Carlot0327/Wireless-signal-transmission-Signal-processor/5.document/20251323-航空语音通信质量监测与报警系统-胡伟畅-刘丹、黄建宇/20251323-航空语音通信质量监测与报警系统-胡伟畅-刘丹、黄建宇-项目海报/微信图片_20260104143353_129_1.jpg

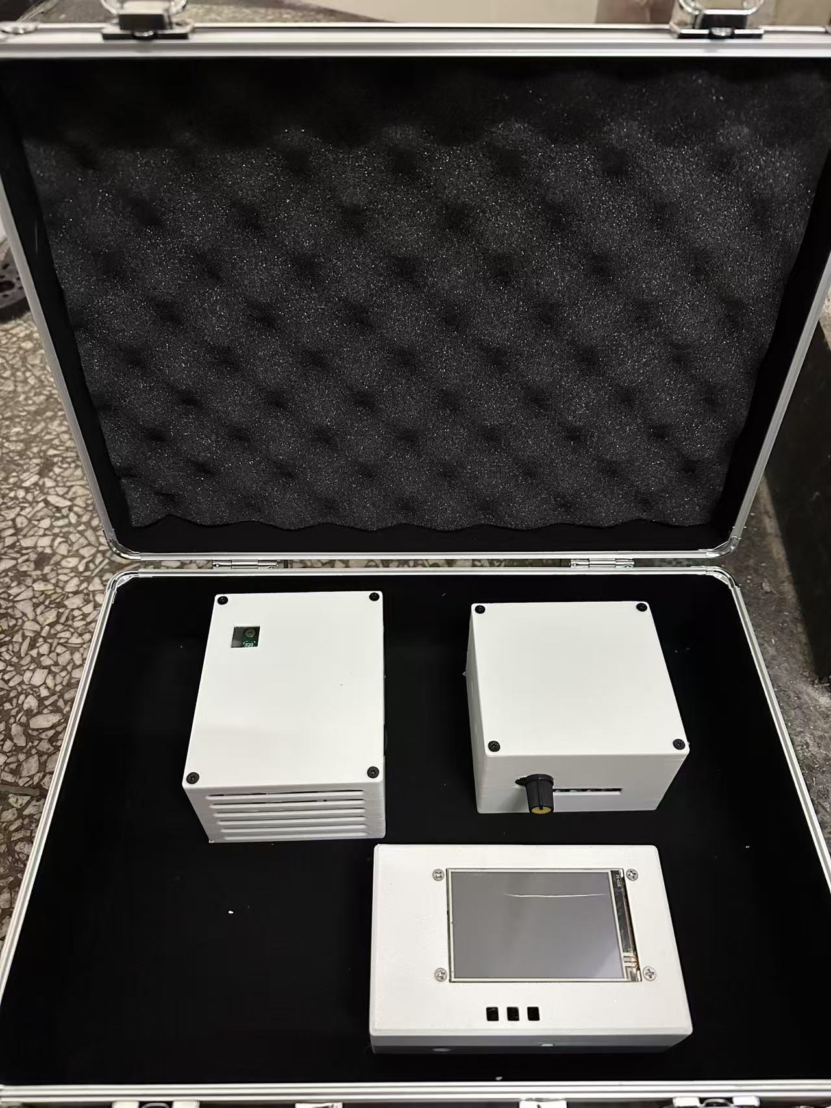
5.document/20251323-航空语音通信质量监测与报警系统-胡伟畅-刘丹、黄建宇/20251323-航空语音通信质量监测与报警系统-胡伟畅-刘丹、黄建宇-项目海报/微信图片_20260104143353_129_1.jpg
