Carlot0327/Wireless-signal-transmission-Signal-processor/5.document/航空语音通信质量与报警系统项目商业计划书.docx

商业计划书

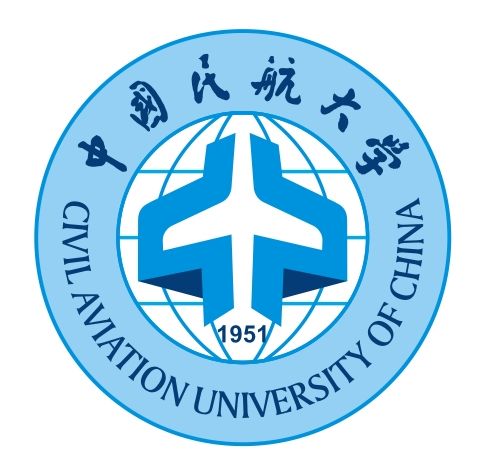
[picture p120: figure]

航空语音通信质量检测与报警系统

团队编号： | 2025-13-23
学生姓名： | 胡伟畅、郝成城、丰国庆、刘相炜、李竺韵
专 业： | 电子信息工程（CDIO试点班）、工商管理
| （卓越试点班）
指导教师： | 刘丹、黄建宇、张明凤
学 院： | 电子信息与自动化学院、经济与管理学院

二〇二五年十二月

目录

## 摘要

本项目精准聚焦现代航空语音通信领域的核心安全痛点，研发集多重功能于一体的航空语音通信质量监测与报警系统，构建全流程闭环管控体系，填补中小型航空企业及科研机构的技术空白。核心核心信息如下：

核心定位：破解地空传输链路信号受电磁干扰、环境噪声、设备老化等因素影响导致的通信质量下降难题，保障航空航行安全。

核心技术路线：采用低功率中波模拟通信技术，融合STM32嵌入式实时处理与MATLAB高精度信号分析双路径方案，符合国家无电台执照设备功率管控要求。

核心性能指标：

- 检测带宽：150~4.5kHz
- 频带分辨率：35Hz
- 检测分辨率：0.01dB
- 失真度分辨率：0.01%
- 报警响应时间：<1s

核心功能覆盖：信号实时采集、关键指标分析、异常快速报警、数据存储与可视化展示。

项目核心竞争优势源于模块化架构设计与全链条成本控制，形成四大核心壁垒，支撑市场竞争力与商业化推广：

兼容性优势：模块化设计+标准化接口，可灵活对接不同型号航空通信设备，覆盖通用航空运维、机场安全巡检、设备研发测试、科研教学实验等多元场景。

成本优势：硬件总成本严格控制在1354.78元以内，远低于行业同类设备3000元以上的成本水平，性价比突出，易切入中低端市场。

技术稳定性优势：硬件采用磁珠隔离、去耦电容等抗干扰设计，双路径数据处理方案协同优化，可在复杂环境下稳定运行，满足航空通信实时性、可靠性要求。

合规性优势：发射功率≤10W，符合国家无线电管理规定，无需额外申请电台执照，降低客户准入门槛与运营成本。

# 第1章 项目概述

## 1.1 项目背景

地空语音通信是航空运输体系的核心纽带，其质量稳定性直接关系飞行安全。

### 1.1.1 通信链路核心隐患

自然环境干扰：大气噪声、雷电天气等导致信号衰减、失真；

人为电磁干扰：机场周边工业设备、民用通信设备等产生的辐射信号破坏通信完整性；

设备自身故障：航空器通信设备老化、地面接收装置故障等引发通信中断或质量下降。

### 1.1.2 行业安全需求迫切

据民航局发布的《通用航空安全发展报告》统计，近年来我国通用航空领域因通信质量问题引发的安全事件占比达15%以上，其中60%以上的事件与通信信号干扰、设备故障未及时发现相关，凸显了通信质量实时监测的必要性与紧迫性。

### 1.1.3 政策合规要求严格

我国明确规定无电台执照设备发射功率不得超过10W，传统航空通信模拟系统难以满足合规要求。当前市场主流航空通信监测设备参数对比情况如下表所示：

表 1 当前市场主流航空通信监测设备参数对比情况

参数维度 | 本项目产品 | 传统高端设备 | 传统中端设备
发射功率 | ≤10W（合规） | 20-50W（需电台执照） | 15-25W（需电台执照）
市场售价（元） | 2800-4500 | 8000-15000 | 3000-8000
操作难度 | 简单（触摸操作，即插即用） | 复杂（需专业调试） | 中等（需电脑辅助）
信噪比测量精度 | ±2dB | ±1dB | ±3dB
失真度测量精度 | ±1% | ±0.5% | ±2%

由上表可知，本项目产品在保障核心测量精度基本满足需求的前提下，具备明显的合规性与成本优势，同时操作难度更低，更适配中低端市场需求。

### 1.1.4 市场供给缺口显著

从市场需求结构来看，当前航空通信监测市场呈现“两极分化”特征：

高端市场被少数国际品牌垄断，功率偏大、结构复杂、调试难度高、成本高昂（3000-8000元）、操作繁琐，主要服务于大型航空公司与枢纽机场；

中低端市场则存在明显供给缺口，中小型航空企业、地方机场、航空院校等主体的低成本、轻量化监测需求，航空院校的易用性、经济性教学科研需求均存在供给空白。

在此行业背景下，市场亟需一款兼具低成本、高可靠性、符合合规要求、操作便捷的航空语音通信质量监测解决方案，以填补中小型航空企业及科研机构的市场空白，完善航空通信安全保障体系的细分领域覆盖，推动航空通信监测行业的普惠化、规范化发展。本项目正是基于这一市场痛点，精准定位中低端市场，通过技术创新与成本优化，打造符合市场需求的高性价比产品，具备广阔的市场发展空间。

## 1.2 产品介绍

### 1.2.1 核心功能

系统核心功能围绕“实时监测、精准分析、快速预警、数据留存”四大核心目标构建，形成全流程闭环管控体系，各功能模块协同工作，确保通信质量的全方位掌控。

信号采集与实时监测环节，系统通过高精度音频采集模块对航空语音通信信号进行持续采集，采样率≥20kHz，可完整捕捉语音信号的细节特征，同时同步采集通信链路的电压、电流等辅助参数，为后续分析提供全面数据支撑。采集到的信号经预处理后，传输至STM32核心处理单元，实时分析信噪比、失真度等关键质量指标，分析结果通过触摸串口屏实时展示，工作人员可直观掌握通信质量动态变化，实现对通信链路的全天候实时监控。

异常报警功能是保障飞行安全的关键环节，系统预设信噪比、失真度等指标的安全阈值，当检测到通信链路故障、信号干扰或指标超标等异常情况时，可快速触发声光报警机制：蜂鸣器发出高频报警声，音量≥80dB，确保在嘈杂的机场环境中工作人员能够及时察觉；RGB LED灯发出红色闪烁灯光，通过视觉警示强化报警效果，整个报警响应时间≤1s，为故障处置争取宝贵时间。同时，系统支持报警阈值自定义设置，客户可根据自身使用场景与通信设备特性，灵活调整阈值参数，提升报警功能的适配性。

数据处理层面，系统创新采用“本地实时处理+云端精准分析”的双模式架构，兼顾时效性与精度需求。本地处理模式依托STM32芯片的强大运算能力，实现指标计算与数据格式转换，满足现场快速分析与决策需求；云端精准分析模式则通过TRS接口将采集到的原始信号传输至MATLAB系统，利用MATLAB的专业信号处理算法开展高精度降噪处理与离线深度分析，可精准提取信号特征参数，生成详细的数据分析报告，为设备性能优化、通信链路升级等提供深度数据支撑。此外，双模式架构支持数据互通与协同优化，本地处理的关键数据可同步至MATLAB系统进行二次校验，MATLAB的分析模型参数也可反向同步至本地系统，提升实时处理精度。

数据存储与可视化展示功能为后续运维与分析提供坚实保障。系统配备大容量本地存储模块，可连续存储不少于30天的监测数据（含原始信号、指标分析结果、报警记录等），支持按时间、设备编号、故障类型等多维度检索，方便工作人员追溯历史数据、排查故障根源。可视化展示通过分辨率≥800×480像素的触摸串口屏实现，采用直观的图表化呈现方式：实时显示信噪比、失真度等核心指标的动态变化曲线，用不同颜色标注指标正常、预警、超标三种状态；同步展示通信信号的频谱图，清晰呈现信号频率分布与干扰情况。同时，触摸操作支持参数设置、数据导出、报警记录查询等功能，工作人员可通过屏幕直接完成操作，无需额外连接电脑，大幅提升现场使用便捷性。

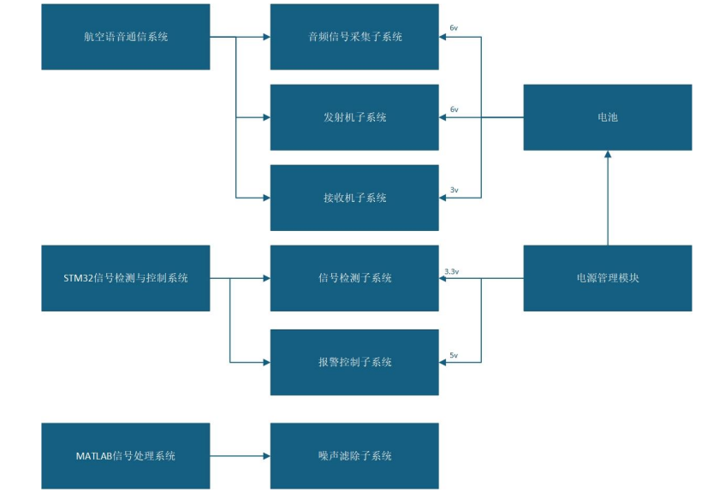
[picture p121: figure]

### 图 1 总系统图

### 1.2.2 技术参数

系统核心技术参数经严格测试校准，全面覆盖质量测量、通信性能、信号处理、环境适应四大维度，确保满足实际应用需求：

核心质量指标测量参数：检测带宽：150~4.5kHz；频带分辨率：35Hz；检测分辨率：信噪比0.01dB；失真度：0.01%；报警响应时间：<1s。

通信性能参数：工作频率范围为1000kHz~2000kHz；发射功率≤10W，符合国家无线电设备功率规定，无需额外申请电台执照。

信号处理参数：信号采样率≥20kHz；分析能力支持256点浮点FFT运算，具备良好的信号分析与频谱解析能力。

环境适应性参数：工作温度范围为-10℃~50℃；相对湿度范围为30%~80%；平均无故障工作时间≥1h，可适配机场露天运维、室内科研实验等多场景。

### 1.2.3 系统架构

系统采用模块化分层架构设计，主要由四大核心模块组成，各模块协同工作实现全功能落地。

航空语音模拟通信系统作为信号源核心，包含音频采集、发射机、接收机三大子模块，依次完成语音信号的采集捕捉、调制发射与解调还原，为后续监测分析提供稳定的信号输入；

STM32信号检测与控制系统是整个系统的核心处理单元，承担信号采集、关键指标计算、异常报警触发以及人机交互控制等核心任务，保障系统的实时响应能力；

MATLAB信号处理系统作为高精度分析补充，通过TRS接口接收STM32传输的信号数据，开展高精度降噪处理与离线深度分析，提升数据处理的灵活性与精度；

辅助模块则包含电源管理与人机交互两大子模块，其中电源管理模块可稳定提供3V、3.3V、5V多种电压输出，满足不同元器件的供电需求，人机交互模块通过触摸串口屏实现操作指令输入与数据展示，提升系统易用性。

# 第2章 市场分析

## 2.1 市场需求

航空通信监测市场需求呈现多元化、刚性化特征，核心聚焦三大领域，各领域需求场景与痛点明确：

### 2.1.1 通用航空领域需求

我国通用航空企业数量持续增长，中小型航空公司与通航机场预算有限、运维团队规模小，对低成本、易操作的通信质量监测设备需求迫切，用于日常运维与故障排查，保障飞行作业安全。

### 2.1.2 航空设备制造领域需求

航空设备厂商研发迭代与出厂检测时需可靠的模拟监测系统，但传统设备测试成本高、周期长，而本产品可提供精准信噪比、失真度等指标数据的监测设备，为产品性能优化与质量把控提供数据支撑。

### 2.1.3 教育科研领域需求

航空院校在电子信息工程、通信工程等专业的教学与科研中，缺乏低成本的模拟通信实验平台，难以支撑教学实践与科研项目，需要低成本的模拟通信实验平台，本项目产品兼具实操性与数据精准性的实验设备，可进行通信原理演示、信号分析实践及作为科研实验载体，可满足教学与科研双重需求。

## 2.2 市场竞争优势

相较于行业同类产品，本项目产品形成四大核心竞争优势，构建差异化市场竞争力：

### 2.2.1 成本优势：极致控本，性价比领先

通过三大措施实现成本优化：一是模块化设计减少冗余元器件，提升物料利用率；二是核心元器件批量采购，通过供应商议价降低单位成本；三是PCB打样选择具备免费额度的专业厂商，节省加工成本。最终实现总成本1354.78元，远低于行业同类设备，快速切入中低端市场。

### 2.2.2 合规性优势：政策适配，准入门槛低

系统发射功率严格控制在≤10W，完全符合《中华人民共和国无线电管理条例》要求，客户无需额外申请电台执照即可合规使用，大幅降低资质办理成本与时间成本，实现“即买即用”。

### 2.2.3 技术优势：精准高效，稳定可靠

双路径处理：STM32本地实时处理保障响应速度，MATLAB云端分析保障精度，兼顾不同场景需求；

抗干扰设计：硬件电路采用磁珠隔离、去耦电容等专业设计，可抵御复杂电磁环境干扰，确保数据精准可靠。

### 2.2.4 易用性优势：操作便捷，运维成本低

配备分辨率≥800×480像素的高分辨率触摸串口屏，操作界面直观简洁，支持本地直接控制与数据查看，无需专业技术人员即可快速上手，降低人员培训成本与现场运维效率。

# 第3章 运营计划

## 3.1 研发流程

项目研发遵循“阶段化推进、全流程验证”的核心逻辑，整体规划16周周期，分四大阶段有序开展，确保产品质量与研发效率平衡：

## ①第一阶段：方案论证与详细设计（1-4周）

核心任务：完成核心器件选型、系统原理图绘制、洞洞板验证、元器件采购；

关键措施：通过Multisim平台提前验证原理图可行性，规避设计风险；选择京东电子、立创商城等正规渠道采购元器件，保障物料可靠性。

## ② 第二阶段：分模块开发与算法仿真（5-10周）

核心任务：推进PCB设计与打样、硬件焊接调试、STM32底层驱动开发、MATLAB信号处理程序开发；

关键措施：各模块并行开发并单独调试，确保单个模块性能达标后再进入集成阶段。

## ③第三阶段：子系统实现与初步集成（11-13周）

核心任务：搭建无线收发链路，完成各子系统测试与初步集成；

关键措施：重点验证各模块协同工作能力，聚焦核心功能的稳定性与兼容性。

## ④第四阶段：系统联调、优化与总结（14-16周）

核心任务：开展对比测试、参数优化、72小时压力测试，完善产品性能；整理技术文档；

关键措施：通过压力测试验证系统长期运行稳定性，形成完整技术文档，为生产与推广提供支撑。

## 3.2 生产计划

生产计划围绕“供应链稳定、生产高效、品质可控”三大目标，从供应链管理、生产模式、质量控制三个维度构建全流程体系：

### 3.2.1供应链管理：稳定可控，成本优化

采购渠道：核心元器件（STM32F407ZGT6、陶晶驰串口屏等）通过京东电子、立创商城等正规渠道采购，保障品质；

成本控制：核心元器件批量采购降低单位成本；PCB打样与嘉立创等专业厂商合作，利用免费打板额度节省加工成本。

### 3.2.2 生产模式：灵活适配，风险可控

初期模式：采用小批量定制生产，根据订单需求精准组织生产，月产能50-100套；

优势：避免库存积压，降低资金占用，可快速响应客户个性化需求；

长期规划：随着市场需求增长，逐步扩大产能，提升规模化生产效率。

### 3.2.3 质量控制：全流程把关，品质保障

建立“多环节检测、全流程追溯”的质量体系，确保产品合格率≥98%：

元器件验收：对采购元器件进行性能测试，剔除不合格品；

过程检测：PCB焊接后开展电路连通性测试，软件开发后进行算法精度测试；

成品测试：系统集成后开展功能完整性测试、稳定性测试，确保交付品质。

## 3.3 销售与推广

### 3.3.1 销售渠道：多渠道协同，精准覆盖

构建“直接销售+渠道合作+线上推广”的三维销售渠道体系，实现不同客户群体的精准覆盖：

直接销售：针对航空设备制造商、大型通航企业等核心企业客户，组建专业销售团队开展一对一洽谈，提供定制化解决方案，提升订单转化率；

渠道合作：与航空设备经销商、教育装备供应商建立长期合作关系，借助其现有市场渠道与客户资源，扩大市场覆盖范围，降低渠道开拓成本；

线上推广：依托航空行业垂直平台（如民航资源网）、学术论坛（如中国航空学会论坛）、社交媒体（如 LinkedIn 行业账号）展示产品功能与案例，吸引科研机构、中小型企业等线上客户。

### 3.3.2 推广策略：场景化营销，口碑构建

聚焦客户需求场景，通过多元化推广手段提升品牌认知与产品认可度：

展会推广：参加中国国际航空航天博览会、全国教育装备展示会等行业展会，现场演示产品功能，与客户面对面沟通，收集潜在需求；

校企合作：与航空院校建立教学合作关系，提供定制化教学实验套装，作为实践教学器材投入使用，通过院校口碑辐射科研领域客户；

试用体验：针对潜在企业客户推出短期免费试用活动，提供上门安装调试与技术支持，收集使用反馈并快速优化产品，以实际效果打动客户；

案例营销：整理典型客户使用案例（如通航企业运维优化、院校科研实验应用），制作案例手册与视频，通过线上线下渠道传播，增强产品说服力。

# 第4章 财务计划

## 4.1 成本预算

### 4.1.1初期总投资与成本构成

表 2 初期投资与成本构成

成本类型 | 金额（元） | 占比
外购部件成本 | 1142.58 | 84.3%
外协加工成本 | 51 | 3.8%
项目管理成本 | 161.2 | 11.9%
合计 | 1354.78 | 100%

项目初期总投资预算3047.2元，实际决算成本1354.78元，成本控制成效显著，具体构成如下：

外购部件成本：1142.58元，占比84.3%，涵盖STM32核心板、音频放大器、触摸屏、电源模块、连接器等核心元器件；

外协加工成本：51元，占比3.8%，主要为铝合金工具箱采购费用（PCB打样利用厂商免费额度，未产生额外成本）；

项目管理成本：161.2元，占比11.9%，包括报告打印、海报制作、会议沟通等前期筹备费用。

### 4.1.2 单位生产成本规划

批量生产后，通过规模效应进一步优化成本：一方面核心元器件批量采购量提升，单位采购成本可降低10%-15%；另一方面生产流程优化，减少人工与物料损耗，最终单位生产成本可控制在1200元以内，为高毛利率奠定基础。

## 4.2 收入预测

### 4.2.1 差异化定价策略

结合市场同类产品价格、自身成本优势及客户付费能力，制定差异化定价体系：

企业客户定价：3500-4500元/套，针对通用航空企业、航空设备制造商等付费能力较强的客户，提供全功能套餐与定制化服务；

院校科研客户定价：2800-3500元/套，针对航空院校等预算敏感型客户，提供基础功能套餐与教学适配服务，提升市场渗透率。

### 4.2.2 分阶段销量与收入预测

基于市场拓展节奏与品牌建设周期，分三年制定销量与收入目标，逐步实现规模化盈利：

第一年度：市场导入期，目标销量300套，预计销售收入90万元，毛利率≥60%；核心任务是完成产品定型，建立初步销售渠道，积累种子客户；

第二年度：市场拓展期，目标销量800套，预计销售收入240万元，毛利率≥65%；核心任务是扩大渠道覆盖，提升品牌认知，实现销量快速增长；

第三年度：市场成熟期，目标销量1500套，预计销售收入450万元，毛利率≥70%；核心任务是形成品牌效应，优化供应链与销售体系，提升盈利水平。

### 4.2.3 分阶段盈利预测

盈利预测基于销量增长、毛利率提升及费用优化，具体如下：

第一年度：扣除生产成本（36万元）、销售费用（15万元）、管理费用（9万元）后，预计净利润30万元；

第二年度：规模效应凸显，生产成本（96万元）、销售费用（40万元）、管理费用（24万元）占比下降，预计净利润80万元；

第三年度：供应链优化进一步降低成本，销售渠道成熟降低渠道费用，预计净利润180万元，盈利能力显著提升。

表 3 分阶段盈利预测

年度 | 销量（套） | 销售收入（万元） | 生产成本（万元） | 销售费用（万元） | 管理费用（万元） | 净利润（万元） | 毛利率
第一年度（市场导入期） | 300 | 90 | 36 | 15 | 9 | 30 | ≥60%
第二年度（市场拓展期） | 800 | 240 | 96 | 40 | 24 | 80 | ≥65%
第三年度（市场成熟期） | 1500 | 450 | 180 | 60 | 30 | 180 | ≥70%

# 第5章 项目融资需求

## 5.1 融资需求测算

结合项目短期商业化落地与中期市场拓展目标，综合考虑研发迭代、产能建设、市场推广、运营储备等核心环节资金需求，经精准测算，本项目拟融资500万元，融资期限3年。资金需求明细如下表所示：

表 4 资金需求明细

资金用途 | 金额（万元） | 占比 | 具体说明
研发迭代资金 | 120 | 24% | 用于产品功能升级（远程数据传输、多链路监测等）、核心算法优化、可靠性测试及技术文档完善，保障产品技术领先性
产能建设资金 | 150 | 30% | 用于标准化生产线搭建、生产设备采购、核心元器件批量储备（3-6个月安全库存）及生产流程优化，支撑月产能提升至200套
市场推广资金 | 130 | 26% | 涵盖行业展会参展、校企合作推广、线上平台运营、销售团队组建与培训、案例营销物料制作等，快速扩大市场覆盖
运营储备资金 | 100 | 20% | 用于日常运营管理、供应链应急保障、客户服务体系搭建及不可预见风险应对，保障项目持续稳定推进
合计 | 500 | 100% | -

## 5.2 融资方案设计

本次融资采用“股权融资+债权融资”的组合模式，兼顾资金稳定性与融资成本控制，具体方案如下：

股权融资：拟出让10%股权，融资300万元。优先引入航空行业产业链资本、科技创业投资机构及高校产学研合作基金，不仅获取资金支持，同时借助投资方的行业资源、技术资源与渠道资源，助力产品推广与技术升级。股权融资后，项目估值可达3000万元，对应第一年度预计净利润30万元，市盈率100倍，符合科技型初创企业估值逻辑。

债权融资：拟通过银行科技型企业信用贷款融资200万元，期限3年，年利率参考同期LPR加点50个基点（预计4.5%-5%）。还款计划采用“等额本息”方式，从第二年度开始还款，利用项目盈利资金逐步偿还，降低初期资金压力。同时，依托高校科研项目背书与核心技术知识产权，提升债权融资获批概率。

## 5.3 投资回报与退出机制

为保障投资方利益，结合项目盈利预测与行业发展规律，设计多元化投资回报与退出路径，具体如下：

### 5.3.1 投资回报测算

分红回报：从第二年度开始，在保证项目持续发展资金需求的前提下，按净利润的30%-50%进行分红。预计第二年度分红24-40万元，第三年度分红54-90万元，股权投资方对应可获得2.4-4万元、5.4-9万元分红回报。

估值增值：随着项目市场份额提升与盈利能力增强，预计第三年度末项目估值可达1.5亿元（对应净利润180万元，市盈率83倍），股权投资方所持10%股权估值可达1500万元，较初始投资300万元实现5倍增值。

### 5.3.2 退出机制设计

股权转让退出：第三年度末，待项目实现规模化盈利与估值提升后，股权投资方可通过向行业龙头企业、大型投资机构转让股权实现退出，预计退出收益率不低于400%。

公司回购退出：若第三年度末项目未达到预期估值，约定由项目公司按“初始投资+同期LPR×1.5×投资年限”的价格回购股权，保障投资方本金与合理收益。

IPO/挂牌退出：长期来看，若项目实现行业领先地位，将启动创业板或北交所IPO筹备工作，投资方可通过资本市场公开交易实现退出，获取更高估值回报。

# 第6章 团队介绍

## 6.1 核心成员

核心团队由4名专业成员与1名非专业成员组成，分工明确、优势互补，覆盖软件开发、硬件设计、调试测试、文献调研、运营预测全流程，具备扎实的技术能力与项目执行能力：

胡伟畅（软件负责人）：核心职责包括STM32底层驱动开发、DSP库调用程序开发、系统集成与串口屏控制程序编写；具备丰富的嵌入式编程经验，熟练掌握C语言、嵌入式系统开发工具，主导软件模块的全流程开发与优化。

郝成城（硬件负责人）：核心职责涵盖系统原理图设计、PCB版图绘制、MATLAB信号处理程序开发与硬件调试；精通硬件电路设计原理与信号处理技术，熟练使用Altium Designer、MATLAB等工具，保障硬件系统的稳定性与兼容性。

丰国庆（调试负责人）：核心职责为利用Multisim平台验证原理图可行性、搭建洞洞板验证环境、开展硬件模块调试；擅长电路测试与问题排查，具备敏锐的故障识别能力，为硬件系统优化提供数据支撑。

刘相炜（文献与辅助负责人）：核心职责包括检索行业技术文献、协助硬件调试与数据记录、撰写项目报告与文档整理；具备扎实的文献调研能力与文字功底，保障项目技术路线的先进性与文档的完整性。

李竺韵（商业计划书负责人）：核心职责为撰写商业计划书，进行产品收入预测与风险分析，给出应对措施，保障项目的可实现性。

## 6.2 指导团队

由中国民航大学刘丹、黄建宇等老师组成指导团队，提供航空通信领域的技术指导与行业资源支持，保障项目技术路线的可行性与先进性。

# 第7章 风险分析与应对措施

## 7..1 技术风险

技术风险主要源于核心元器件供应波动、技术迭代冲击及模块兼容性问题，具体风险与应对措施如下：

### 7.1.1 核心风险描述

供应链风险：核心元器件（如STM32芯片）受市场供需影响，可能出现价格波动、供应短缺，影响生产进度与成本控制；

技术迭代风险：航空通信技术快速发展，若行业出现新型监测技术或替代产品，可能导致本产品竞争力下降；

兼容性风险：硬件调试过程中，不同模块间可能出现兼容性问题，影响系统整体性能。

### 7.1.2 针对性应对措施

供应链保障：与核心元器件供应商签订长期合作协议，锁定价格与供应份额；建立备用供应商名录，避免单一依赖；预留3-6个月的核心元器件安全库存，应对短期供应短缺；

技术迭代应对：建立技术研发跟踪机制，定期关注行业技术动态；预留研发资金，持续优化算法与硬件设计，保持产品技术先进性；加强产学研合作，借助高校科研资源推动技术创新；

兼容性管控：在研发初期开展模块兼容性仿真测试，提前规避风险；分阶段进行模块集成测试，及时发现并解决兼容性问题；建立模块标准化设计规范，提升兼容性。

## 7.2 市场风险

市场风险主要集中在价格竞争与市场认可度不足，具体风险与应对措施如下：

### 7.2.1 核心风险描述

价格竞争风险：行业巨头可能凭借规模优势进入低端市场，采取低价策略挤压市场空间，影响本项目产品的价格竞争力；

市场认可风险：客户对新产品存在信任顾虑，可能导致市场推广进度不及预期，销量难以达到目标。

### 7.2.2 针对性应对措施

强化成本优势：进一步优化供应链管理，提升规模化生产效率，降低单位成本，保持价格竞争力；聚焦细分市场，打造差异化产品功能，避免与巨头直接价格竞争；

提升市场认可度：加大产品演示与试用推广力度，通过实际效果打动客户；收集早期客户案例，开展案例营销，增强产品说服力；与行业协会、院校建立合作，借助其公信力提升品牌信任度；建立快速反馈机制，根据客户需求优化产品，提升用户体验。

## 7.3 运营风险

运营风险主要涉及生产交付与销售转化，具体风险与应对措施如下：

### 7.3.1 核心风险描述

生产交付风险：PCB打样、元器件采购等环节可能出现延期，或生产过程中出现质量问题，影响产品交付进度；

销售转化风险：销售团队经验不足，对行业需求与产品优势把握不精准，导致订单转化效率低。

### 7.3.2 针对性应对措施

保障生产交付：选择口碑良好、产能稳定的外协厂商，提前3-4周提交生产需求，预留缓冲时间；建立严格的质量检测流程，加强生产过程管控，及时发现并解决质量问题；建立生产进度跟踪机制，定期排查潜在延期风险；

提升销售转化：对销售团队开展系统培训，涵盖产品知识、行业需求、沟通技巧等内容；制定销售激励机制，提升团队积极性；建立销售话术手册与案例库，辅助销售团队精准推介产品；建立客户反馈机制，及时解决销售过程中的疑问与问题。

# 第8章 发展规划

## 8.1 短期规划（1-2年）

聚焦产品定型、市场导入与基础能力建设，目标为1-2年内完成商业化落地，具体任务如下：

完成产品定型与规模化生产，建立稳定的供应链与销售渠道。

实现年销量800套以上，覆盖国内10个以上省份的客户，建立初步品牌认知。

持续优化产品性能，拓展产品功能，如增加远程数据传输、多链路同时监测等功能。

## 8.2 中期规划（3-5年）

聚焦市场份额提升与品牌建设，目标为3-5年内成为细分领域领先品牌，具体任务如下：

扩大市场份额，成为中小型航空企业与科研院校通信质量监测设备的首选品牌。

拓展国际市场，针对东南亚、南美等通用航空发展较快的地区进行市场布局。

推出系列化产品，涵盖高、中、低端市场，满足不同客户的个性化需求。

## 8.3 长期规划（5年以上）

聚焦行业引领与业务拓展，目标为5年以上成为航空通信监测领域的领军企业，具体任务如下：

成为航空通信监测领域的领先企业，具备核心技术自主研发与持续创新能力。

拓展业务边界，进入航空通信系统整体解决方案领域，提供监测、维护、优化一体化服务。

加强产学研合作，推动技术成果转化，引领行业技术发展方向。

# 第9章 结论

本项目精准锚定航空通信监测领域中低端市场的刚性需求，具体表现如下：

产品价值：通过低成本、高可靠、合规性强的产品设计，填补了中小型航空企业与科研院校的市场空白，为航空通信安全提供了普惠化解决方案，行业价值显著；

团队能力：核心团队分工明确、技术扎实，搭配专业的高校指导团队，具备产品研发与项目执行的核心能力；

商业可行性：运营计划涵盖研发、生产、销售全流程，逻辑严谨、措施具体；财务预测基于合理的销量与定价假设，盈利前景良好；风险识别全面，应对措施针对性强，风险可控；

发展潜力：通过短期定型落地、中期市场拓展、长期生态构建的分阶段规划，项目有望逐步实现规模化盈利，最终成长为航空通信监测领域的领先企业，为航空安全与行业发展贡献核心力量。

综上所述，本产品凭借低成本、高可靠性、合规性强的核心优势，具备广阔的市场前景与商业价值。项目团队技术实力扎实，研发流程规范，运营计划可行，风险可控。通过精准的市场定位、有效的推广策略与持续的技术迭代，项目有望在短期内实现盈利，长期发展为行业领先的航空通信监测解决方案提供商，为航空安全与行业发展贡献力量。
