Carlot0327/Wireless-signal-transmission-Signal-processor/5.document/20251323-航空语音通信质量监测与报警系统-胡伟畅-刘丹、黄建宇/word文档/0-1-1 项目文档封面.docx

895909@lj200682801

初级项目课程文档

895909@lj200682802

项目名称： | 航空语音通信质量监测与报警系统
团队编号： | 2025-13-23
专业名称： | 电子信息工程（CDIO试点班）
指导老师： | 刘丹 黄建宇
团队成员： | 胡伟畅 郝成城
| 丰国庆 刘相炜

工程技术训练中心

2023年12月

目 录

第一章 项目任务书…………………………………………………01

第二章 方案设计报告………………………………………………02

第三章 详细设计报告………………………………………………16
| 3.1 总体设计报告……………………………………………16
| 3.2 系统设计报告……………………………………………23
| 3.3 电路设计报告……………………………………………40
| 3.4 成本分析报告……………………………………………57
| 3.5 项目管理报告……………………………………………62

第四章 部件测试报告.........................................……68

第五章 实验设计报告………………………………………………………83

第六章 项目决算报告………………………………………………………95

第七章 创业计划书…………………………………………………………101
