Carlot0327/Wireless-signal-transmission-Signal-processor/0.Simulation/发射机原理图.jpg

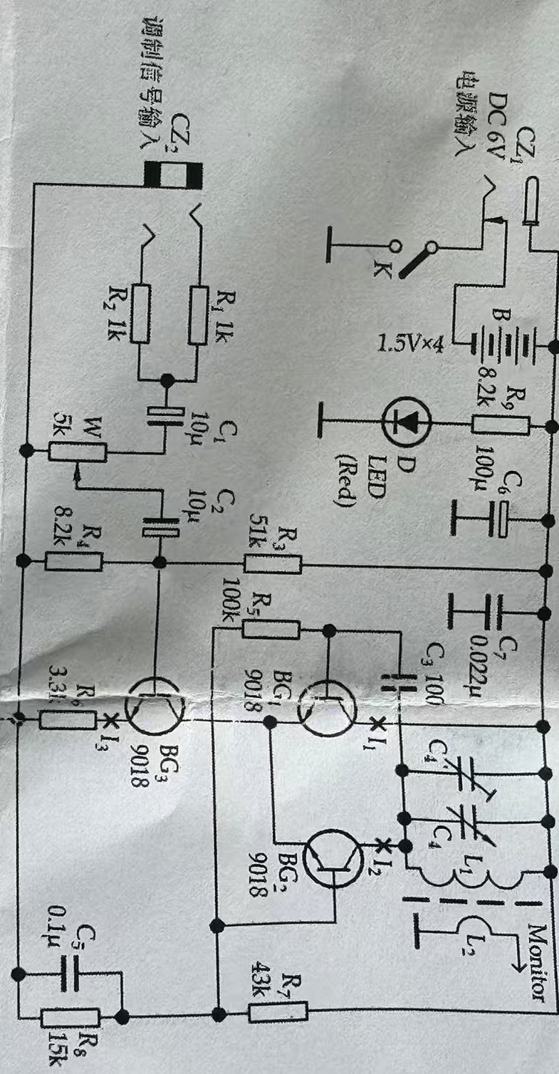
0.Simulation/发射机原理图.jpg
