Carlot0327/Wireless-signal-transmission-Signal-processor/5.document/签名/微信图片_20250917105927_52_750.jpg

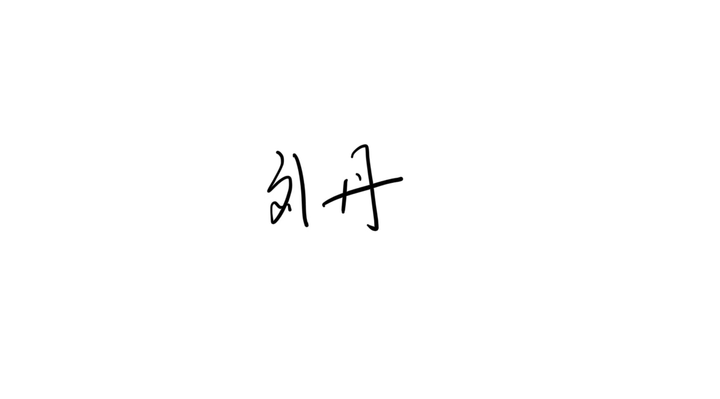
5.document/签名/微信图片_20250917105927_52_750.jpg
