Carlot0327/Wireless-signal-transmission-Signal-processor/4.Model/上壳.3mf

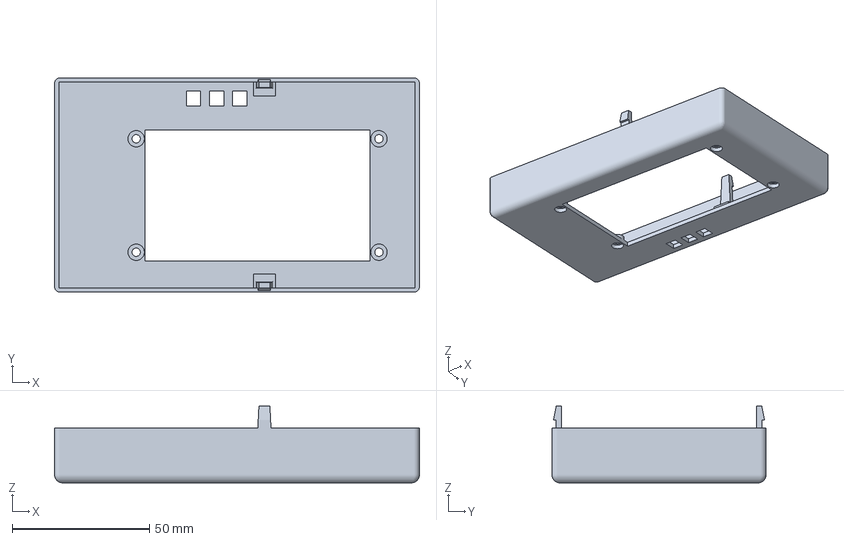
[picture p134: CAD file, 2026-08-30]
4.Model/上壳.3mf
133.2 x 78.2 x 28.0 mm
