Carlot0327/Wireless-signal-transmission-Signal-processor/4.Model/发射机.3mf

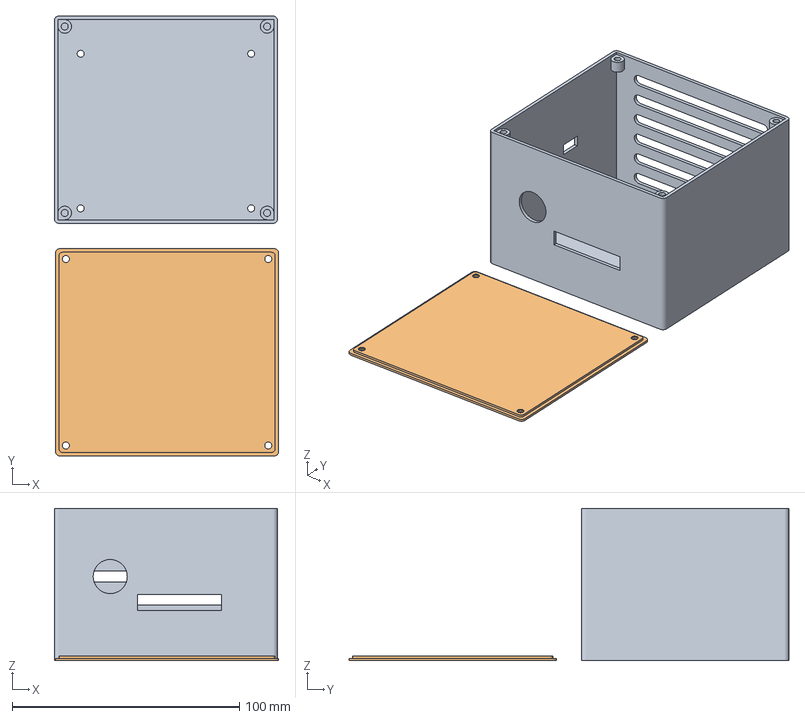
[picture p135: CAD file, 2026-08-30]
4.Model/发射机.3mf
98.7 x 193.5 x 67.0 mm
零件1.1.STL_1.stl
零件1.1.STL_2.stl
