Carlot0327/Wireless-signal-transmission-Signal-processor/4.Model/接收机.3mf

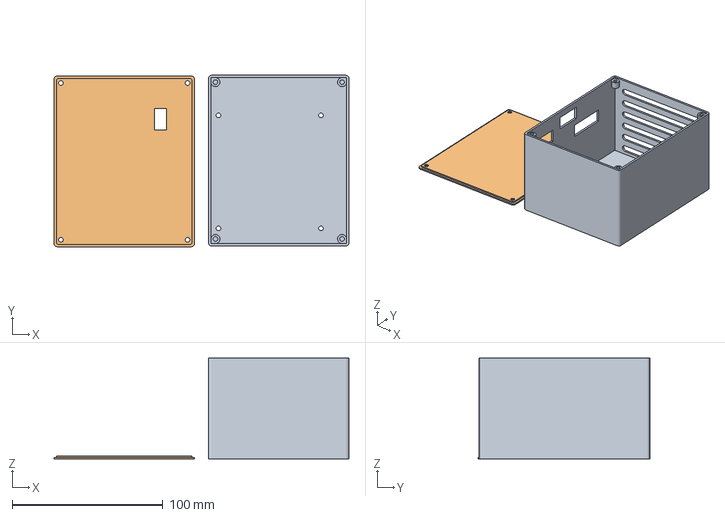
[picture p136: CAD file, 2026-08-30]
4.Model/接收机.3mf
195.7 x 113.8 x 67.0 mm
零件2.1.STL_1.stl
零件2.1.STL_2.stl
