Carlot0327/Wireless-signal-transmission-Signal-processor/4.Model/亚克力.dxf

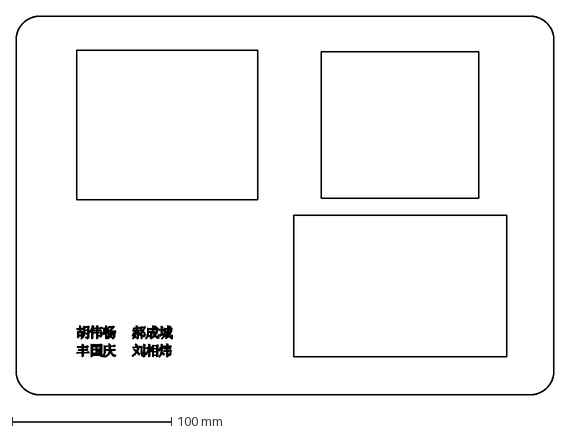
[picture p137: CAD file, 2026-08-30]
4.Model/亚克力.dxf
338.0 x 238.0 mm
