Carlot0327/Wireless-signal-transmission-Signal-processor/(list of files, drawings)

Other design files:
0.Simulation/发射机.ms14
0.Simulation/接收机.ms14
1.Hardware/PCB工程/ProPrj_初级项目_2026-01-11.epro
