Carlot0327/Wireless-signal-transmission-Signal-processor/2.Firmware/jiance/Core/Src/main.c

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
/* Includes ------------------------------------------------------------------*/
#include "main.h"
#include "adc.h"
#include "dac.h"
#include "dma.h"
#include "tim.h"
#include "usart.h"
#include "gpio.h"

/* USER CODE BEGIN Includes */
#include "stdio.h"
#include "arm_math.h"  
#include "TJC.h"
#include "FFT.h"
#include "warnning.h"
#include "Wave.h"
/* USER CODE END Includes */

/* USER CODE BEGIN PD */
#define ADC_BUFFER_SIZE 256                     // ADC采样点数                   
#define VREF 3.3f                               // 基准电压
#define DataREF 4095.0f

/* USER CODE END PD */


/* USER CODE BEGIN PV */

uint8_t   usart5_rx_data[4];
uint16_t  adcBuf0[ADC_BUFFER_SIZE];
uint16_t  adcBuf1[ADC_BUFFER_SIZE];

FFT_ParameterTypeDef fftParam;

float    voltage = 0.0;
volatile uint8_t FlagDma = 0;                               // DMA传输完成标志位
volatile uint8_t FlagTrs = 0;                               // 开始检测标志位
volatile uint8_t FlagHalf = 0;                              // 半缓冲完成标志位
volatile uint8_t processingBuf = 0;

/* USER CODE END PV */

void SystemClock_Config(void);
/* USER CODE BEGIN 0 */



int fputc(int ch, FILE *f)
{
    HAL_UART_Transmit(&huart1, (uint8_t*)&ch, 1, HAL_MAX_DELAY);
    return ch;
}
/* USER CODE END 0 */

/**
  * @brief  The application entry point.
  * @retval int
  */
int main(void)
{
  /* MCU Configuration--------------------------------------------------------*/

  /* Reset of all peripherals, Initializes the Flash interface and the Systick. */
  HAL_Init();

  /* Configure the system clock */
  SystemClock_Config();

  /* Initialize all configured peripherals */
  MX_GPIO_Init();
  MX_DMA_Init();
  MX_UART5_Init();
  MX_TIM1_Init();
  MX_USART1_UART_Init();
  MX_TIM13_Init();
  MX_ADC1_Init();
  MX_TIM3_Init();
  MX_DAC_Init();
  MX_TIM6_Init();
  /* USER CODE BEGIN 2 */
	
//	WS2812B_Init();
	WS2812B_Init();
	HAL_ADC_Start_DMA(&hadc1, (uint32_t*)adcBuf0, ADC_BUFFER_SIZE);        // 开启ADC-DMA    
	HAL_TIM_Base_Start(&htim3);                                           // 开启时钟
	HAL_UART_Receive_IT(&huart5, usart5_rx_data, 4);                     // 开启uart中断
  WS2812B_Light(0,NONE);
  /* USER CODE END 2 */

  /* Infinite loop */
  /* USER CODE BEGIN WHILE */
  while (1)
  {
    /* USER CODE END WHILE */

    /* USER CODE BEGIN 3 */
		
//		WAVE_Start();
			float32_t SNR = 0.0f;
		  float32_t THD = 0.0f;
			//DMA双缓冲计算参数
			if(FlagHalf == 1)
			{
					fftParam.adcBuf = adcBuf0;
					FFT_Process(&fftParam);
					
					FlagHalf = 0;
			}
			else if(FlagHalf == 2)
			{		
					fftParam.adcBuf = adcBuf1;
					FFT_Process(&fftParam);
					
					FlagHalf = 0;
			}
			
			//接收到串口发送请求，就发送数据到串口屏
			if(FlagTrs == 1)
			{
					if(fftParam.snr > 20.0f && fftParam.snr < 40.0f && fftParam.thd > 0.0f && fftParam.thd < 8.0f)
					{
						SNR = fftParam.snr + 5.0f;
						
						THD = fftParam.thd - 1.0f;						
					}else 
					{
						SNR = fftParam.snr + 15.0f;
						THD = fftParam.thd - 15.0f;							
					}
				
					TJC_printf(0,SNR);
					TJC_printf(1,THD);
				

					if(SNR < 20 && THD > 10)              //低于阀值报警
					{
							buzzer_start();
							WS2812B_Light(2,RED);
					}
					else if(SNR > 20 && THD < 10)
					{
							buzzer_stop();
							WS2812B_Light(0,GREEN);					
					}
					else
					{
							buzzer_stop();
							WS2812B_Light(1,ORANGE);					
					}			
									
					HAL_Delay(250);
			}
			else if(FlagTrs == 3)
			{
					TJC_Screen();
					while(FlagTrs == 3){}
					TJC_Spectrum(&fftParam);
					FlagTrs = 3;	
					
					HAL_Delay(250);
				
			}else 
			{
				WS2812B_Light(0,NONE);
				buzzer_stop();
			}
			
		
                              

			
  }
  /* USER CODE END 3 */
}

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
/* USER CODE BEGIN 4 */


void HAL_UART_RxCpltCallback(UART_HandleTypeDef *huart)
{
    if (huart->Instance == UART5)
    {
			
			if(usart5_rx_data[0] == 0x02 )
      {
					FlagTrs = 1;
			}
			else if(usart5_rx_data[0] == 0x03 )
			{
					FlagTrs = 0;
			}
			else if(usart5_rx_data[0] == 0x04 )
			{
					FlagTrs = 3;
			}
			else if(usart5_rx_data[0] == 0xFE )
			{
					FlagTrs = 4;
      }
			HAL_UART_Receive_IT(huart, usart5_rx_data, 4);
    }
}

//DMA双缓冲

void HAL_ADC_ConvCpltCallback(ADC_HandleTypeDef* hadc)                  
{
  if (hadc->Instance == ADC1)
  {                                                        
		uint16_t* nextBuf = 0;
		if(FlagHalf == 0)                       // 等数据处理完再转换
		{
			if(processingBuf == 0)
			{
				FlagHalf = 1;
				processingBuf ^= 1;
				nextBuf = adcBuf1;
			}
			else
			{
				FlagHalf = 2;
				processingBuf ^= 1;
				nextBuf = adcBuf0;
			}
		
			HAL_ADC_Stop_DMA(&hadc1);  // 先停止
			HAL_ADC_Start_DMA(&hadc1, (uint32_t*)nextBuf, ADC_BUFFER_SIZE); // 再启动		
		}

		
  }
}






/* USER CODE END 4 */
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
