Carlot0327/Wireless-signal-transmission-Signal-processor/2.Firmware/jiance/jiance.ioc

Mcu.UserName=STM32F407ZGTx
PA10.Signal=USART1_RX
PA13.Signal=SYS_JTMS-SWDIO
PA14.Signal=SYS_JTCK-SWCLK
PA4.Signal=COMP_DAC1_group
PA5.Signal=ADCx_IN5
PA9.Signal=USART1_TX
PC12.Signal=UART5_TX
PC13-ANTI_TAMP.Signal=GPIO_Output
PD2.Signal=UART5_RX
PE11.Signal=S_TIM1_CH2
PF8.Signal=S_TIM13_CH1
PH0-OSC_IN.Signal=RCC_OSC_IN
PH1-OSC_OUT.Signal=RCC_OSC_OUT
