Carlot0327/Wireless-signal-transmission-Signal-processor/(notices)

Notices in the files:
2.Firmware/jiance/Core/Src/main.c:
Copyright (c) 2025 STMicroelectronics.
All rights reserved.
This software is licensed under terms that can be found in the LICENSE file
